W5TSU/LinHT-hw/audio.kicad_sch

## KiCad design audio.kicad_sch (2026-09-17)

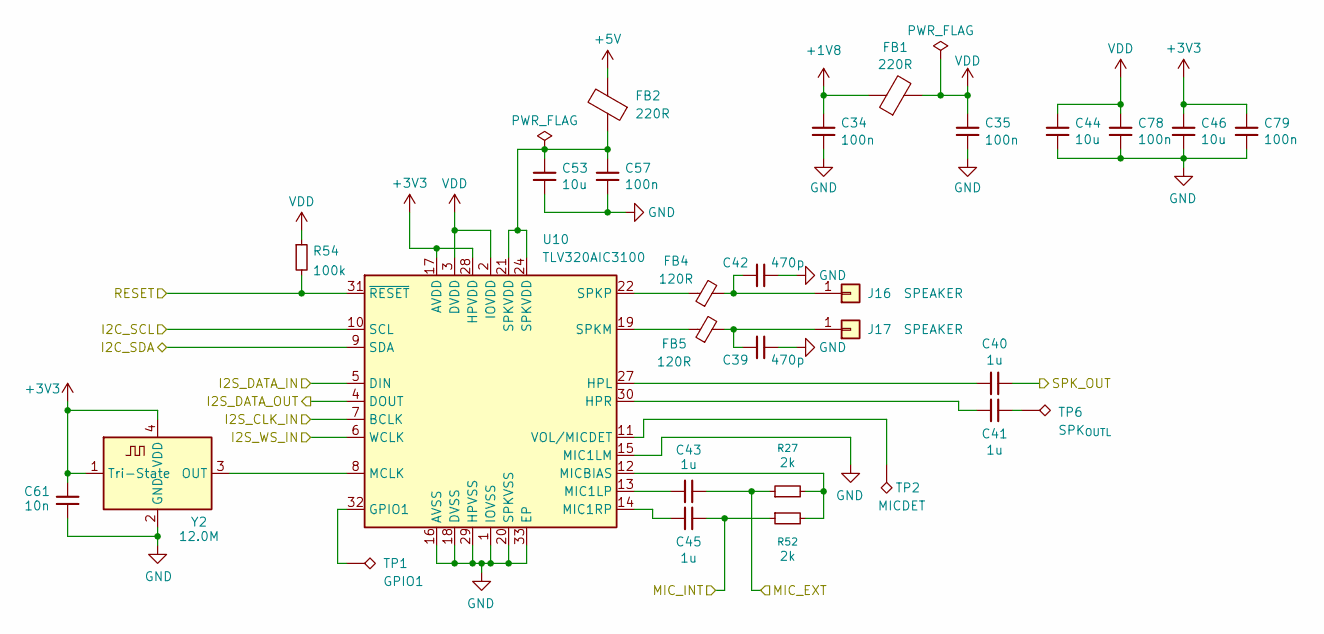
[picture p1: schematic audio.kicad_sch]

Parts:
C34, C35, C57, C78, C79: 100n; C_0402_1005Metric; MPN CL05B104KO5NNNC; LCSC C1525
C39, C42: 470p; C_0402_1005Metric; MPN CC0402JRNPO9BN471; LCSC C106259
C40, C41, C43, C45: 1u; C_0402_1005Metric; MPN CL05A105KA5NQNC; LCSC C52923
C44, C46, C53: 10u; C_0402_1005Metric; MPN CL05A106MQ5NUNC; LCSC C15525
C61: 10n; C_0402_1005Metric; MPN CL05B103KO5NNNC; LCSC C318577
FB1, FB2: 220R; L_0805_2012Metric; MPN BLM21PG221SN1D; LCSC C85840
FB4, FB5: 120R; L_0805_2012Metric; MPN BLM21PG121SN1D; LCSC C79382
J16, J17: SPEAKER; TestPoint_Pad_D4.0mm
R27, R52: 2k; R_0402_1005Metric; MPN 0402WGF2001TCE; LCSC C4109
R54: 100k; R_0402_1005Metric; MPN 0402WGF1003TCE; LCSC C25741
TP1: GPIO1; TestPoint_Pad_D1.0mm
TP2: MICDET; TestPoint_Pad_D1.0mm
TP6: SPK_{OUTL}; TestPoint_Pad_D1.0mm
U10: TLV320AIC3100; VQFN-32-1EP_5x5mm_P0.5mm_EP3.5x3.5mm; MPN TLV320AIC3100IRHBR; LCSC C478458
Y2: 12.0M; Oscillator_SMD_ECS_2520MV-xxx-xx-4Pin_2.5x2.0mm; MPN ECS-2520MV-120-BN-TR; LCSC C17241106

Connections:
+1V8: C34.1, FB1.1
+3V3: C46.1, C61.1, C79.1, U10.17 (AVDD), U10.28 (HPVDD), Y2.1 (Tri-State), Y2.4 (VDD)
+5V: FB2.2
GND: C34.2, C35.2, C39.2, C42.2, C44.2, C46.2, C53.2, C57.2, C61.2, C78.2, C79.2, U10.1 (IOVSS), U10.15 (MIC1LM), U10.16 (AVSS), U10.18 (DVSS), U10.20 (SPKVSS), U10.25 (SPKVSS), U10.29 (HPVSS), U10.33 (EP), Y2.2 (GND)
I2C_SCL: U10.10 (SCL)
I2C_SDA: U10.9 (SDA)
I2S_CLK_IN: U10.7 (BCLK)
I2S_DATA_IN: U10.5 (DIN)
I2S_DATA_OUT: U10.4 (DOUT)
I2S_WS_IN: U10.6 (WCLK)
MIC_EXT: C43.2, R27.1
MIC_INT: C45.2, R52.1
unnamed: C39.1, FB5.2, J17.1
unnamed: C40.2, U10.27 (HPL)
unnamed: C41.1, TP6.1
unnamed: C41.2, U10.30 (HPR)
unnamed: C42.1, FB4.2, J16.1
unnamed: C43.1, U10.13 (MIC1LP)
unnamed: C45.1, U10.14 (MIC1RP)
unnamed: C53.1, C57.1, FB2.1, U10.21 (SPKVDD), U10.24 (SPKVDD)
unnamed: FB4.1, U10.22 (SPKP), U10.26 (SPKP)
unnamed: FB5.1, U10.19 (SPKM), U10.23 (SPKM)
unnamed: R27.2, R52.2, U10.12 (MICBIAS)
unnamed: TP1.1, U10.32 (GPIO1)
unnamed: TP2.1, U10.11 (VOL/MICDET)
unnamed: U10.8 (MCLK), Y2.3 (OUT)
RESET: R54.2, U10.31 (~RESET)
SPK_OUT: C40.1
VDD: C35.1, C44.1, C78.1, FB1.2, R54.1, U10.2 (IOVDD), U10.3 (DVDD)
