W5TSU/LinHT-hw/connectors.kicad_sch

## KiCad design connectors.kicad_sch (2026-09-17)

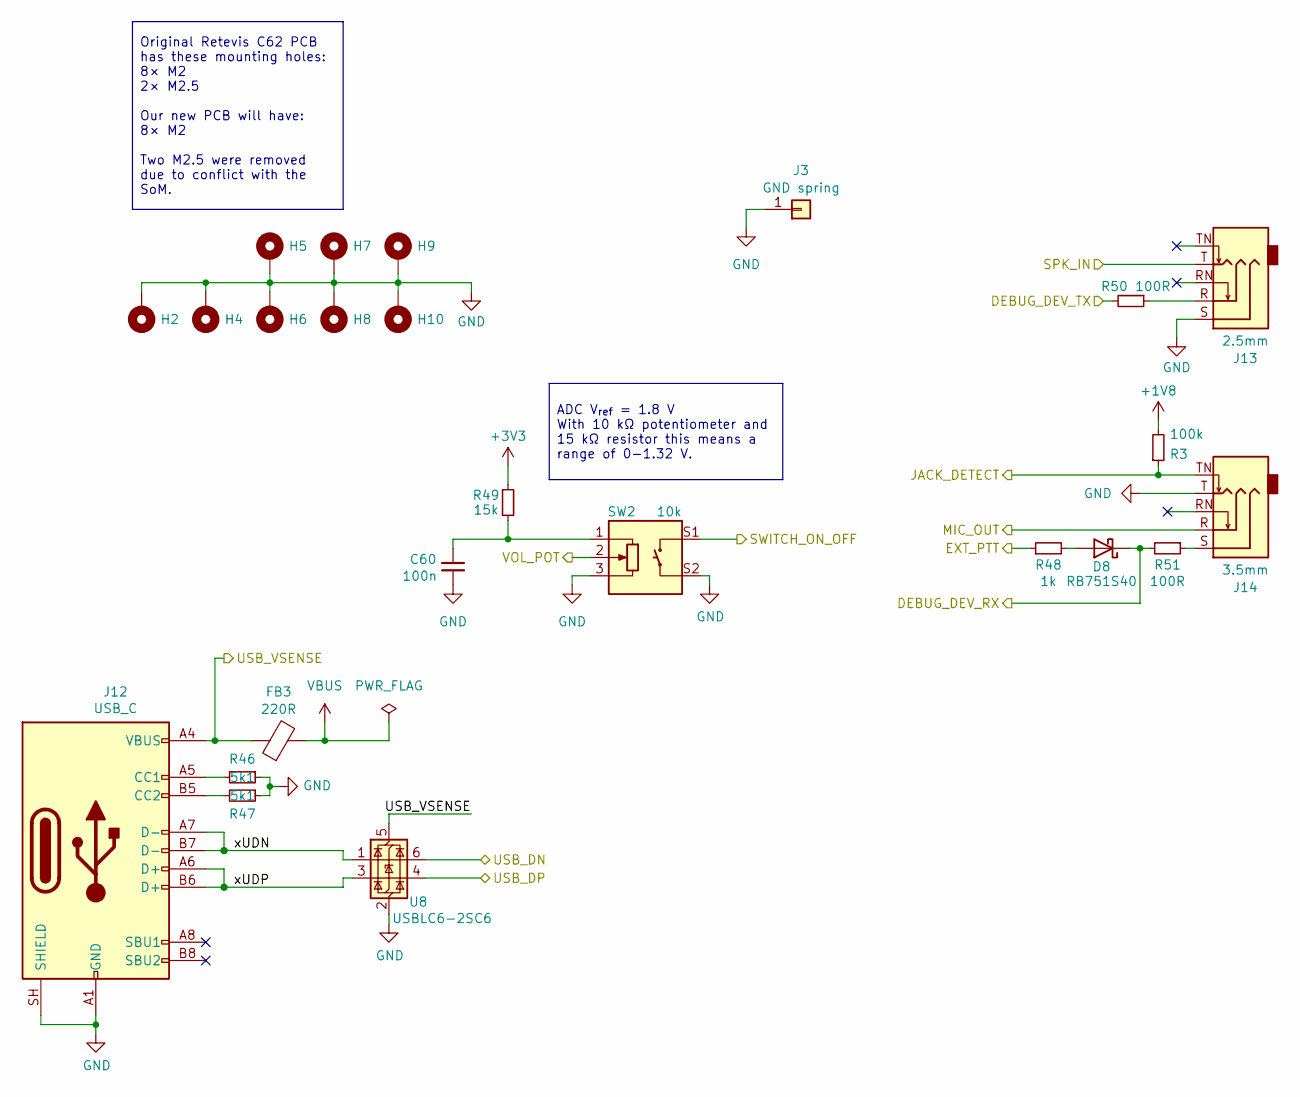
[picture p2: schematic connectors.kicad_sch]

Parts:
C60: 100n; C_0402_1005Metric; MPN CL05B104KO5NNNC; LCSC C1525
D8: RB751S40; D_SOD-523; MPN RB751S40T1G; LCSC C5178963
FB3: 220R; L_0805_2012Metric; MPN BLM21PG221SN1D; LCSC C85840
H2, H4, H5, H6, H7, H8, H9, H10: MountingHole_Pad; MountingHole_2.2mm_M2_DIN965_Pad
J3: GND spring; TestPoint_Pad_D4.0mm
J12: USB_C; USB_C_Receptacle_HRO_TYPE-C-31-M-12; MPN TYPE-C-31-M-12; LCSC C165948
J13: 2.5mm; Jack_2.5mm_PJ-204_nodrill_Horizontal
J14: 3.5mm; Jack_3.5mm_CUI_SJ1-3525N_Modified
R3: 100k; R_0402_1005Metric; MPN 0402WGF1003TCE; LCSC C25741
R46, R47: 5k1; R_0402_1005Metric; MPN 0402WGF5101TCE; LCSC C25905
R48: 1k; R_0402_1005Metric; MPN 0402WGF1001TCE; LCSC C11702
R49: 15k; R_0402_1005Metric; MPN 0402WGF1502TCE; LCSC C25756
R50, R51: 100R; R_0402_1005Metric; MPN 0402WGF1000TCE; LCSC C25076
SW2: 10k; Connector_08x09mm_pot_switch
U8: USBLC6-2SC6; SOT-23-6; MPN USBLC6-2-SC6; LCSC C7519

Connections:
+1V8: R3.2
+3V3: R49.1
DEBUG_DEV_RX: D8.1 (K), R51.2
DEBUG_DEV_TX: R50.2
EXT_PTT: R48.1
GND: C60.2, H2.1, H4.1, H5.1, H6.1, H7.1, H8.1, H9.1, H10.1, J3.1, J12.A1 (GND), J12.A12 (GND), J12.B1 (GND), J12.B12 (GND), J12.SH (SHIELD), J13.S, J14.T, R46.1, R47.1, SW2.3, SW2.S2, U8.2 (GND)
JACK_DETECT: J14.TN, R3.1
MIC_OUT: J14.R
unnamed: C60.1, R49.2, SW2.1
unnamed: D8.2 (A), R48.2
unnamed: J12.A5 (CC1), R46.2
unnamed: J12.B5 (CC2), R47.2
unnamed: J13.R, R50.1
unnamed: J14.S, R51.1
SPK_IN: J13.T
SWITCH_ON_OFF: SW2.S1
USB_DN: U8.6 (I/O1)
USB_DP: U8.4 (I/O2)
USB_VSENSE: FB3.1, J12.A4 (VBUS), J12.A9 (VBUS), J12.B4 (VBUS), J12.B9 (VBUS), U8.5 (VBUS)
VBUS: FB3.2
VOL_POT: SW2.2
xUDN: J12.A7 (D-), J12.B7 (D-), U8.1 (I/O1)
xUDP: J12.A6 (D+), J12.B6 (D+), U8.3 (I/O2)

Notes on the sheet:
ADC V_{ref} = 1.8 V With 10 kΩ potentiometer and 15 kΩ resistor this means a range of 0-1.32 V.
Original Retevis C62 PCB has these mounting holes: 8× M2 2× M2.5 Our new PCB will have: 8× M2 Two M2.5 were removed due to conflict with the SoM.
