W5TSU/LinHT-hw/display.kicad_sch

## KiCad design display.kicad_sch (2026-09-17)

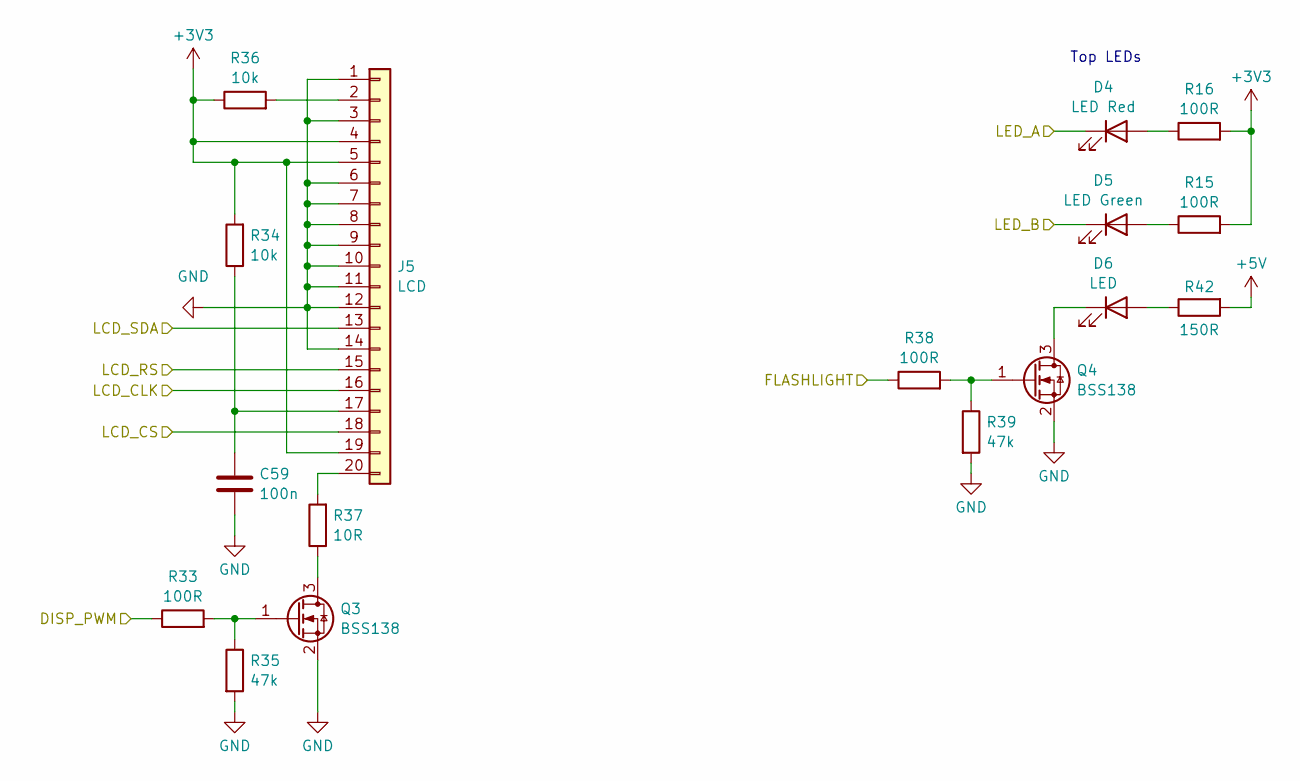
[picture p3: schematic display.kicad_sch]

Parts:
C59: 100n; C_0402_1005Metric; MPN CL05B104KO5NNNC; LCSC C1525
D4: LED Red; LED_0402_1005Metric; MPN SM0402RC
D5: LED Green; LED_0402_1005Metric; MPN SM0402GC
D6: LED; LED_Rectangular_W3.0mm_H2.0mm
J5: LCD; Connector_FFC_01x20_P0.75mm
Q3, Q4: BSS138; SOT-23; MPN BSS138-7-F; LCSC C40912
R15, R16, R33, R38: 100R; R_0402_1005Metric; MPN 0402WGF1000TCE; LCSC C25076
R34, R36: 10k; R_0402_1005Metric; MPN 0402WGF1002TCE; LCSC C25744
R35, R39: 47k; R_0402_1005Metric; MPN 0402WGF4702TCE; LCSC C25792
R37: 10R; R_0402_1005Metric; MPN 0402WGF100JTCE; LCSC C25077
R42: 150R; R_0402_1005Metric; MPN 0402WGF1500TCE; LCSC C25082

Connections:
+3V3: J5.4, J5.5, J5.19, R15.2, R16.2, R34.2, R36.1
+5V: R42.2
DISP_PWM: R33.1
FLASHLIGHT: R38.1
GND: C59.2, J5.1, J5.3, J5.6, J5.7, J5.8, J5.9, J5.10, J5.11, J5.12, J5.14, Q3.2 (S), Q4.2 (S), R35.2, R39.2
LCD_CLK: J5.16
LCD_CS: J5.18
LCD_RS: J5.15
LCD_SDA: J5.13
LED_A: D4.1 (K)
LED_B: D5.1 (K)
unnamed: C59.1, J5.17, R34.1
unnamed: D4.2 (A), R16.1
unnamed: D5.2 (A), R15.1
unnamed: D6.1 (K), Q4.3 (D)
unnamed: D6.2 (A), R42.1
unnamed: J5.2, R36.2
unnamed: J5.20, R37.2
unnamed: Q3.1 (G), R33.2, R35.1
unnamed: Q3.3 (D), R37.1
unnamed: Q4.1 (G), R38.2, R39.1

Notes on the sheet:
Top LEDs
