W5TSU/LinHT-hw/gnss.kicad_sch

## KiCad design gnss.kicad_sch (2026-09-17)

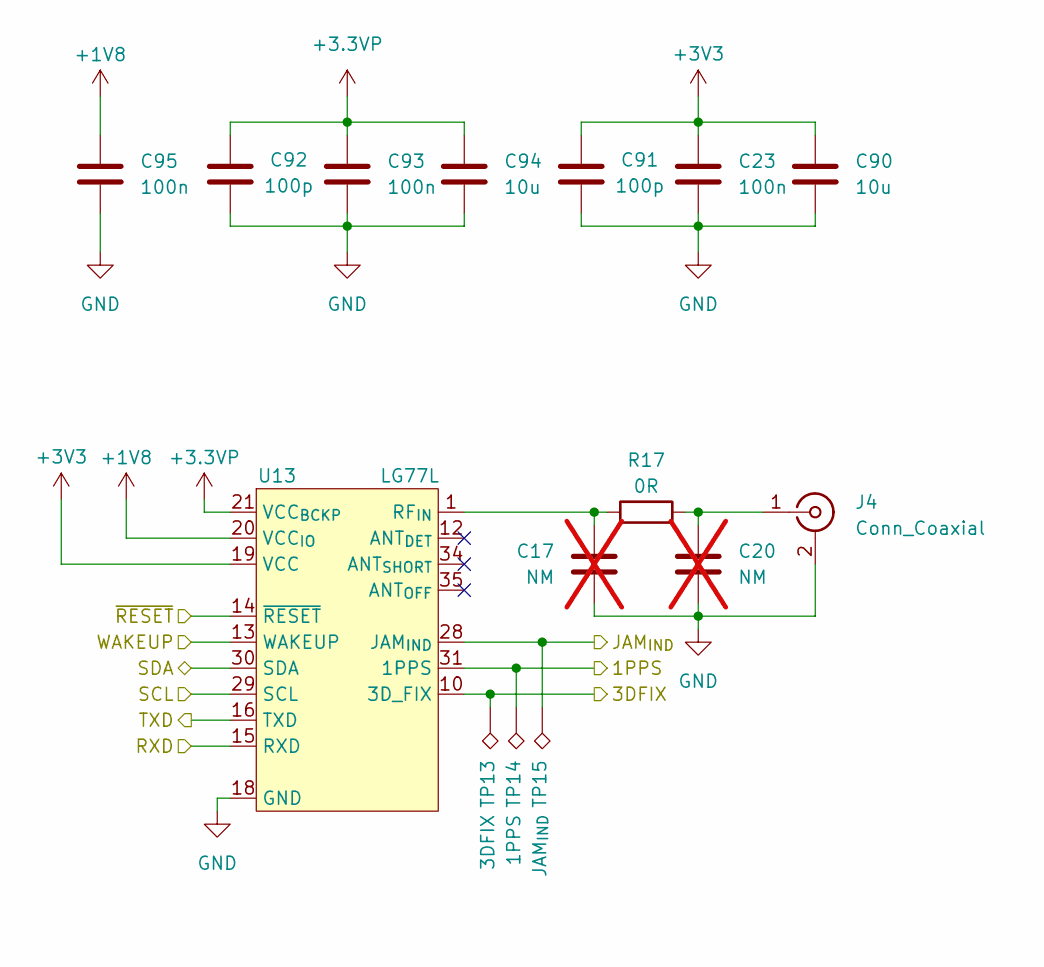
[picture p4: schematic gnss.kicad_sch]

Parts:
C17, C20: NM; C_0402_1005Metric; not fitted
C23, C93, C95: 100n; C_0402_1005Metric; MPN CL05B104KO5NNNC; LCSC C1525
C90, C94: 10u; C_0805_2012Metric; MPN CL21A106KBYQNNE; LCSC C2932476
C91, C92: 100p; C_0402_1005Metric; MPN GRM1555C1H101JA01D; LCSC C77177
J4: Conn_Coaxial; Connector_ufl_1909763-1; MPN 1909763-1; LCSC C392444
R17: 0R; R_0402_1005Metric; MPN 0402WGF0000TCE; LCSC C17168
TP13: 3DFIX; TestPoint_Pad_D1.0mm
TP14: 1PPS; TestPoint_Pad_D1.0mm
TP15: JAM_{IND}; TestPoint_Pad_D1.0mm
U13: LG77L; MPN LG77LICMD

Connections:
1PPS: TP14.1, U13.31 (1PPS)
3DFIX: TP13.1, U13.10 (3D_FIX)
+1V8: C95.1, U13.20 (VCC_{IO})
+3.3VP: C92.2, C93.1, C94.1, U13.21 (VCC_{BCKP})
+3V3: C23.1, C90.1, C91.2, U13.19 (VCC)
GND: C17.2, C20.2, C23.2, C90.2, C91.1, C92.1, C93.2, C94.2, C95.2, J4.2 (Ext), U13.2 (GND), U13.18 (GND), U13.37 (GND), U13.38 (GND), U13.39 (GND), U13.40 (GND), U13.41 (GND), U13.42 (GND), U13.43 (GND)
JAM_{IND}: TP15.1, U13.28 (JAM_{IND})
unnamed: C17.1, R17.1, U13.1 (RF_{IN})
unnamed: C20.1, J4.1 (In), R17.2
unnamed: U13.3 (RES), U13.4 (RES), U13.5 (RES), U13.6 (RES), U13.7 (RES), U13.8 (RES), U13.9 (RES), U13.11 (RES), U13.17 (RES), U13.22 (RES), U13.23 (RES), U13.24 (RES), U13.25 (RES), U13.26 (RES), U13.27 (RES), U13.32 (RES), U13.33 (RES), U13.36 (RES)
RXD: U13.15 (RXD)
SCL: U13.29 (SCL)
SDA: U13.30 (SDA)
TXD: U13.16 (TXD)
WAKEUP: U13.13 (WAKEUP)
~RESET: U13.14 (~RESET)
