W5TSU/LinHT-hw/keyboard.kicad_sch

## KiCad design keyboard.kicad_sch (2026-09-17)

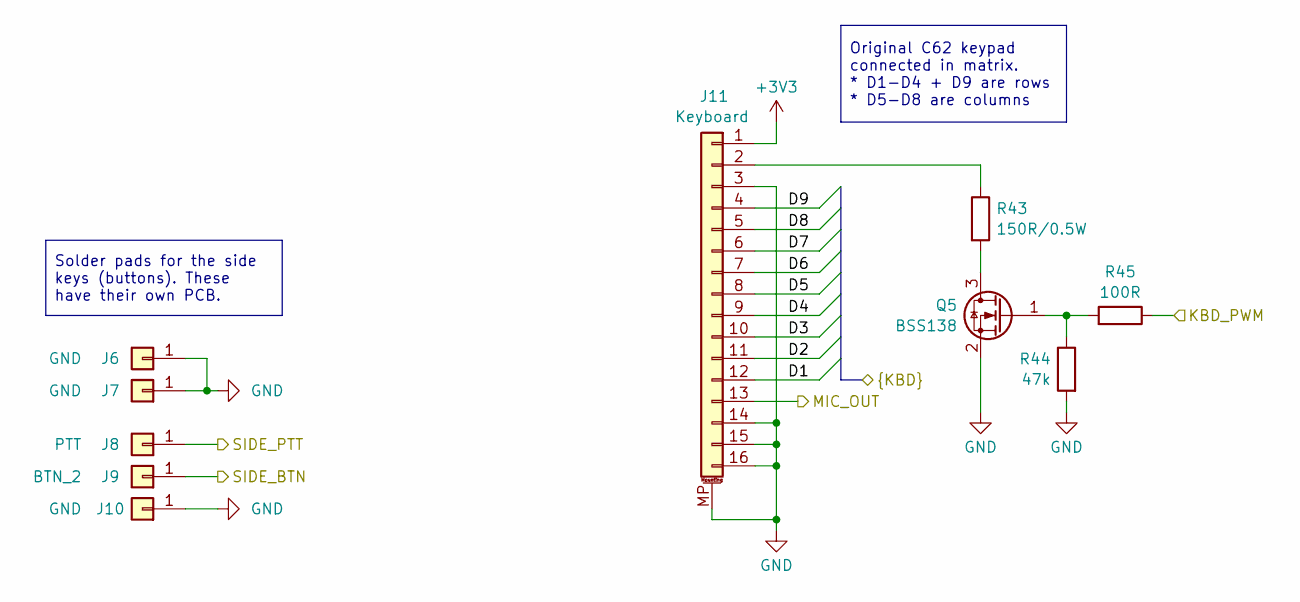
[picture p5: schematic keyboard.kicad_sch]

Parts:
J6, J7, J10: GND; Solder_Pad-1.7x2.2mm
J8: PTT; Solder_Pad-1.7x2.2mm
J9: BTN_2; Solder_Pad-1.7x2.2mm
J11: Keyboard; FPC-SMD_P0.50-16P_FGS-XJ-H2.0; MPN FH12-16S-0.5SH(55)
Q5: BSS138; SOT-23; MPN BSS138-7-F; LCSC C40912
R43: 150R/0.5W; R_0402_1005Metric; MPN ERJPA2F1500X; LCSC C542965
R44: 47k; R_0402_1005Metric; MPN 0402WGF4702TCE; LCSC C25792
R45: 100R; R_0402_1005Metric; MPN 0402WGF1000TCE; LCSC C25076

Connections:
+3V3: J11.1
D1: J11.12
D2: J11.11
D3: J11.10
D4: J11.9
D5: J11.8
D6: J11.7
D7: J11.6
D8: J11.5
D9: J11.4
GND: J6.1, J7.1, J10.1, J11.3, J11.14, J11.15, J11.16, J11.MP (MountPin), Q5.2 (S), R44.2
KBD_PWM: R45.1
MIC_OUT: J11.13
unnamed: J11.2, R43.1
unnamed: Q5.1 (G), R44.1, R45.2
unnamed: Q5.3 (D), R43.2
SIDE_BTN: J9.1
SIDE_PTT: J8.1

Notes on the sheet:
Original C62 keypad connected in matrix. * D1-D4 + D9 are rows * D5-D8 are columns
Solder pads for the side keys (buttons). These have their own PCB.
