W5TSU/LinHT-hw/linht-hw.kicad_sch

## KiCad design linht-hw.kicad_sch (2026-09-17)

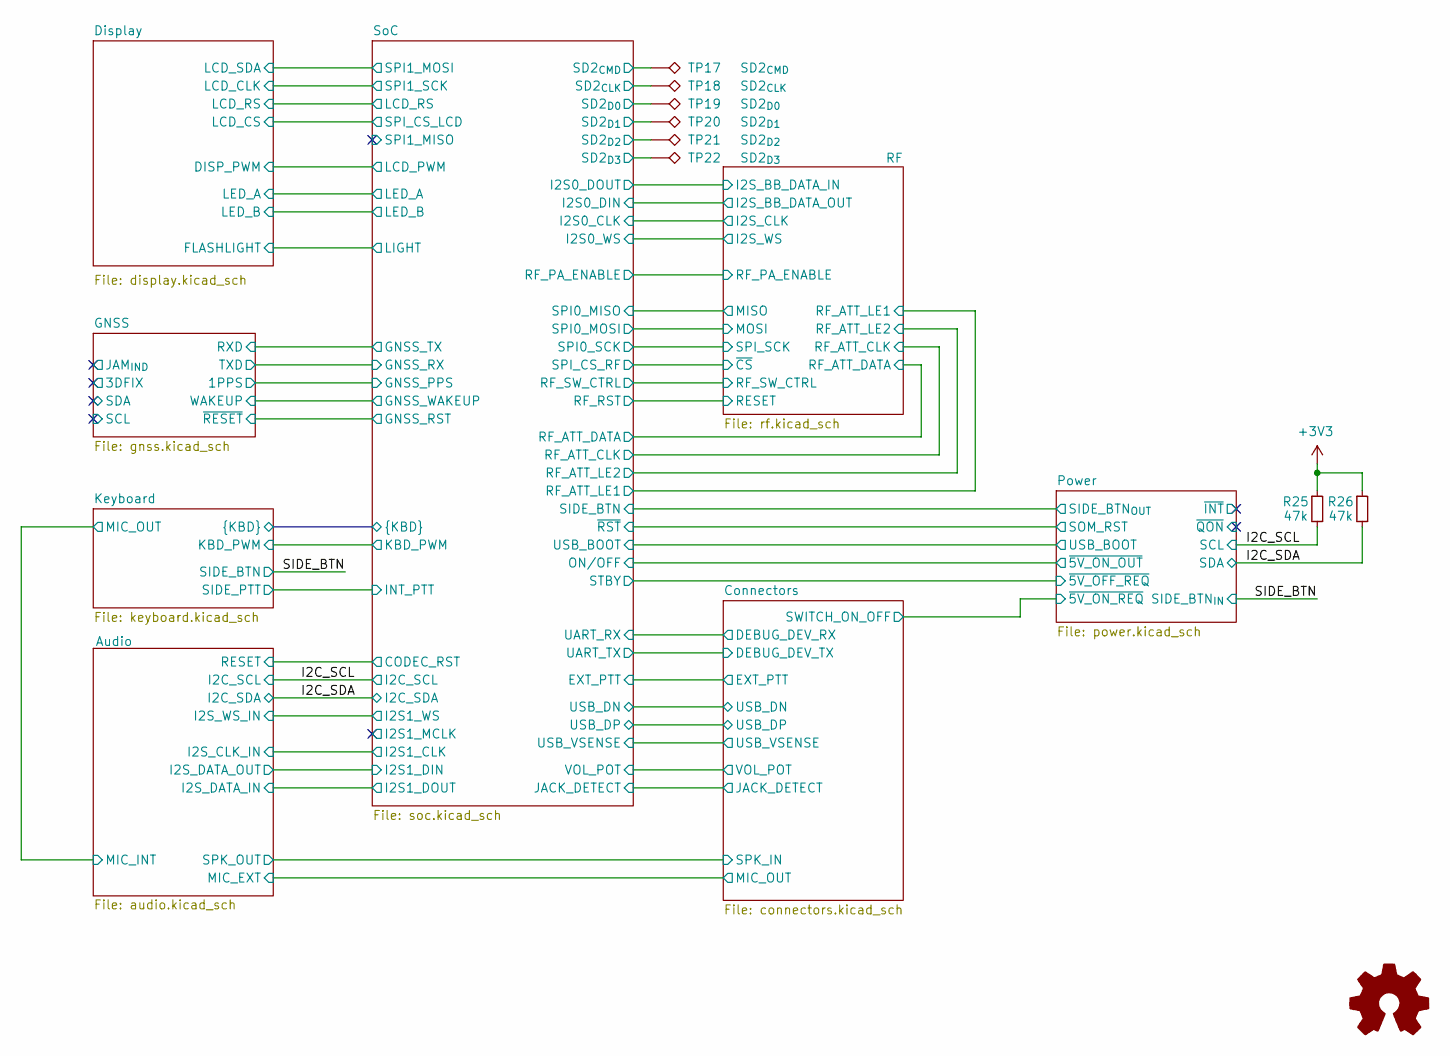
[picture p6: schematic linht-hw.kicad_sch]

Parts:
R25, R26: 47k; R_0402_1005Metric; MPN 0402WGF4702TCE; LCSC C25792
SYM1: Logo_Open_Hardware_Small; OSHW-Logo2_14.6x12mm_SilkScreen
TP17: SD2_{CMD}; TestPoint_Pad_D1.0mm
TP18: SD2_{CLK}; TestPoint_Pad_D1.0mm
TP19: SD2_{D0}; TestPoint_Pad_D1.0mm
TP20: SD2_{D1}; TestPoint_Pad_D1.0mm
TP21: SD2_{D2}; TestPoint_Pad_D1.0mm
TP22: SD2_{D3}; TestPoint_Pad_D1.0mm

Connections:
+3V3: R25.1, R26.1
I2C_SCL: R25.2
I2C_SDA: R26.2
SD2_{CLK}: TP18.1
SD2_{CMD}: TP17.1
SD2_{D0}: TP19.1
SD2_{D1}: TP20.1
SD2_{D2}: TP21.1
SD2_{D3}: TP22.1
