W5TSU/LinHT-hw/mux.kicad_sch

## KiCad design mux.kicad_sch (2026-09-17)

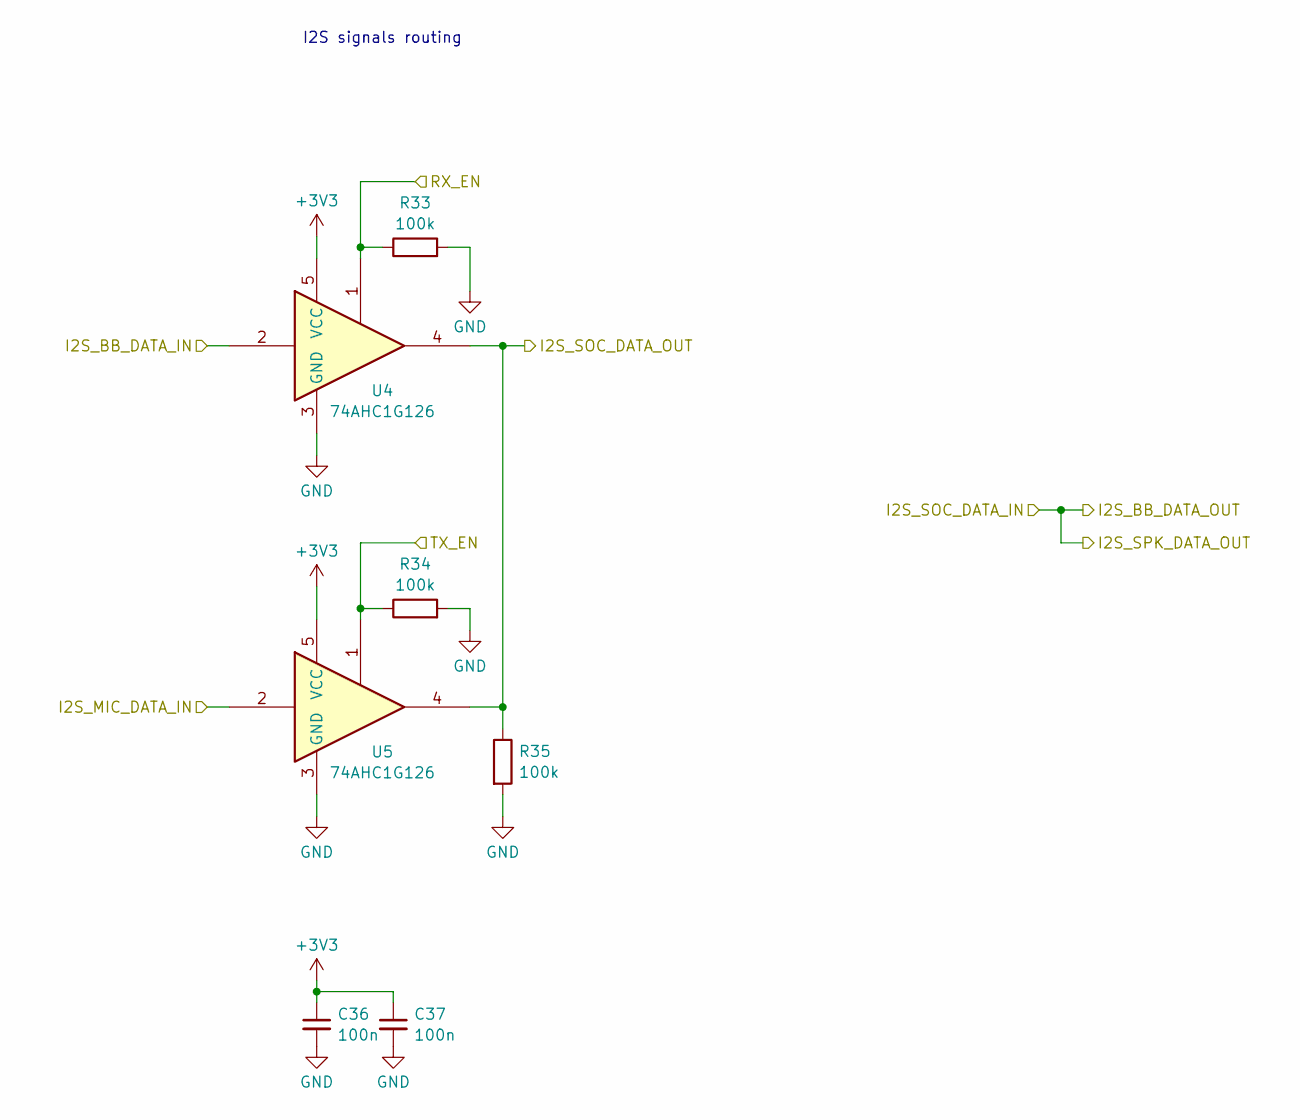
[picture p7: schematic mux.kicad_sch]

Parts:
C36, C37: 100n; C_0402_1005Metric
R33, R34, R35: 100k; R_0402_1005Metric
U4, U5: 74AHC1G126

Connections:
+3V3: C36.1, C37.1, U4.5 (VCC), U5.5 (VCC)
GND: C36.2, C37.2, R33.2, R34.2, R35.2, U4.3 (GND), U5.3 (GND)
I2S_BB_DATA_IN: U4.2
I2S_MIC_DATA_IN: U5.2
I2S_SOC_DATA_OUT: R35.1, U4.4, U5.4
RX_EN: R33.1, U4.1
TX_EN: R34.1, U5.1

Notes on the sheet:
I2S signals routing
