W5TSU/LinHT-hw/power.kicad_sch

## KiCad design power.kicad_sch (2026-09-17)

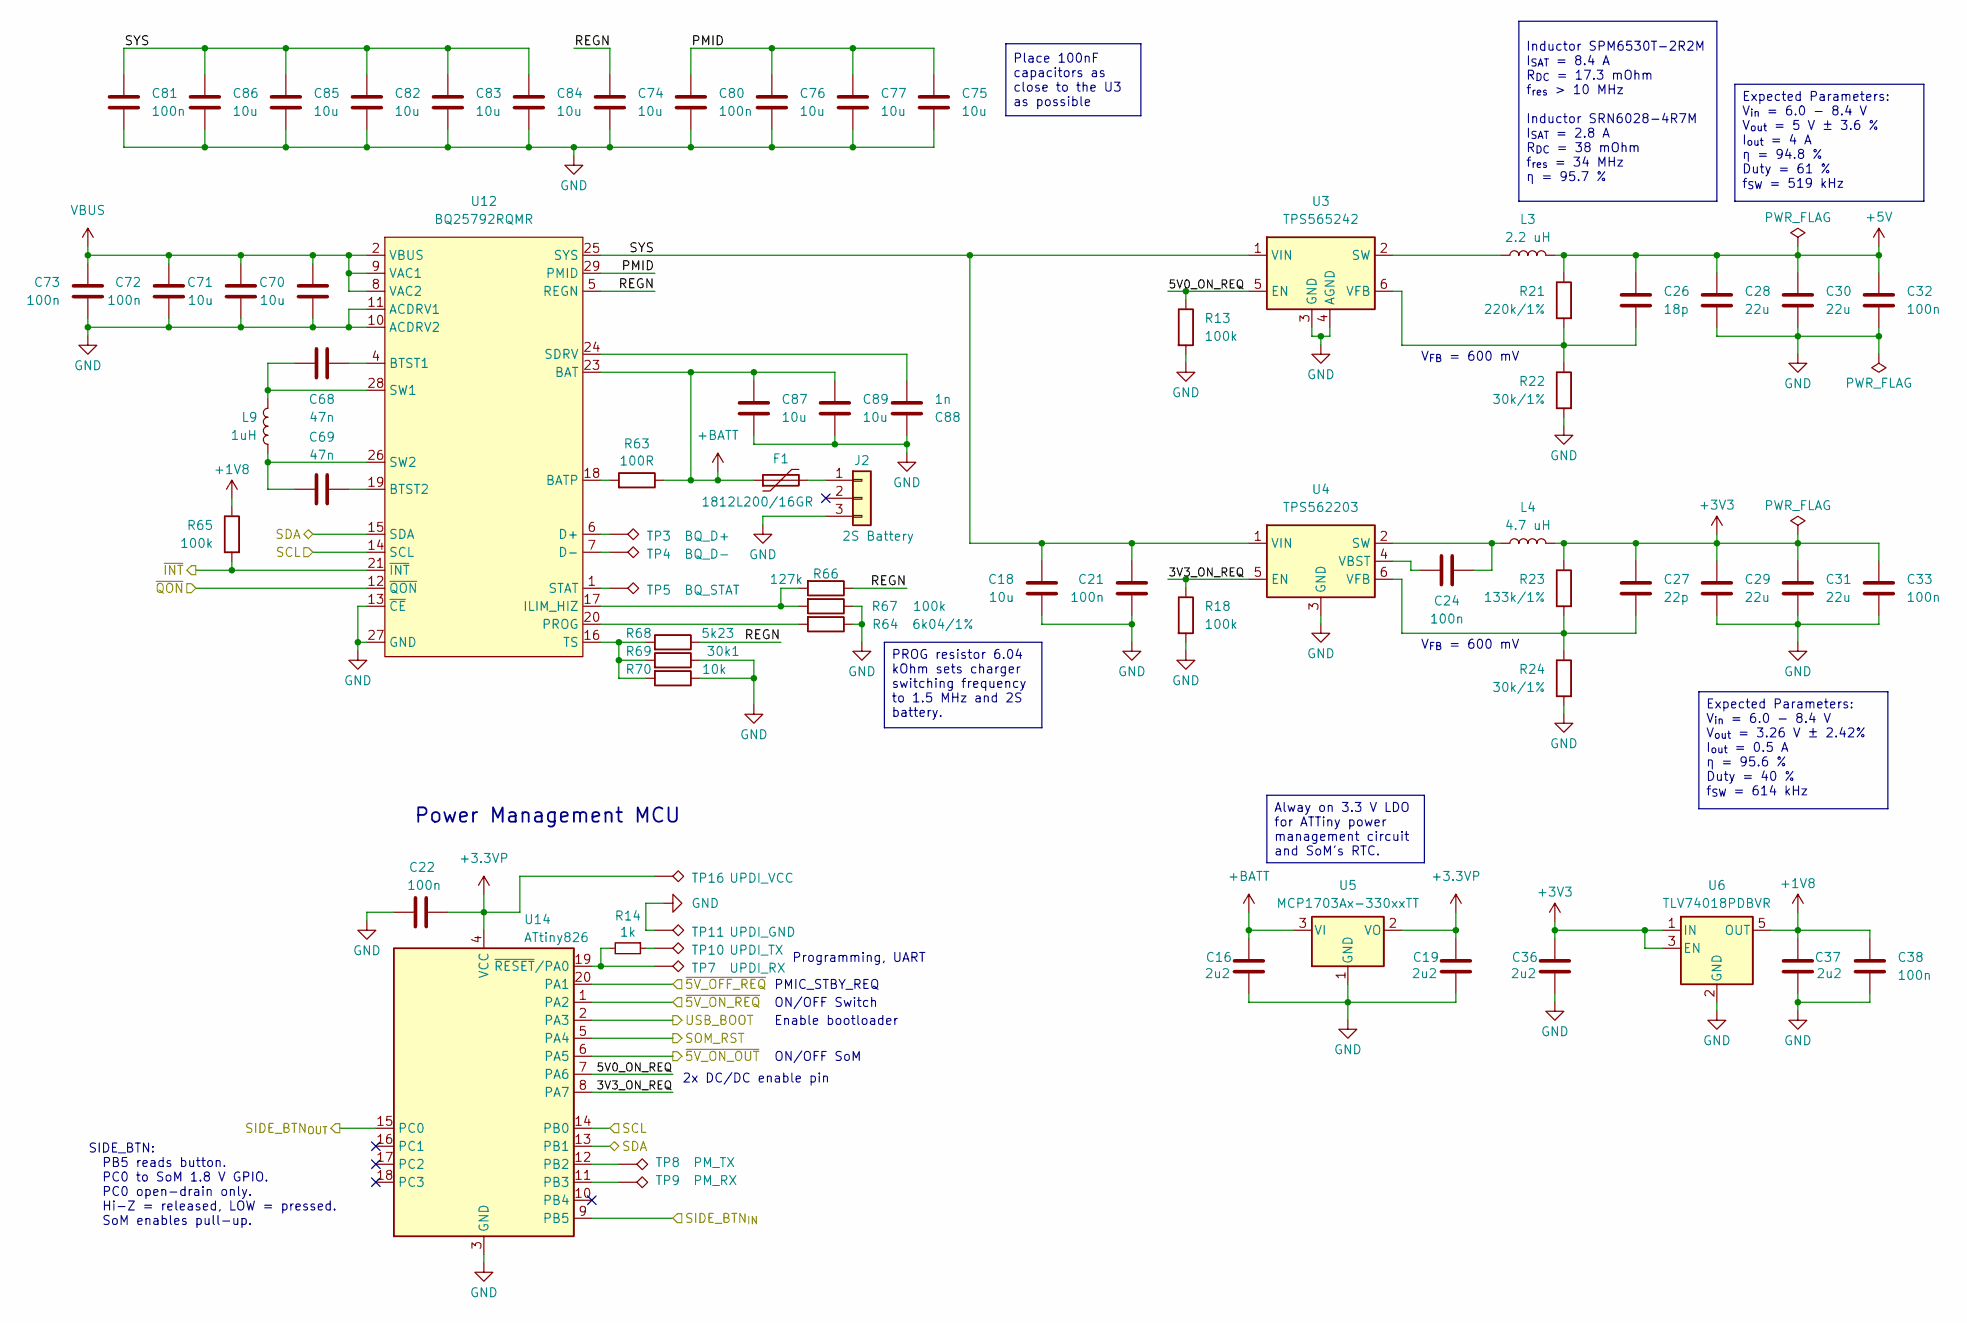
[picture p8: schematic power.kicad_sch]

Parts:
C16, C19, C36, C37: 2u2; C_0402_1005Metric; MPN CL05A225KO5NQNC; LCSC C170151
C18, C70, C71, C74, C75, C76, C77, C82, C83, C84, C85, C86, C87, C89: 10u; C_0805_2012Metric; MPN CL21A106KBYQNNE; LCSC C2932476
C21, C22, C24, C32, C33, C38, C72, C73, C80, C81: 100n; C_0402_1005Metric; MPN CL05B104KO5NNNC; LCSC C1525
C26: 18p; C_0402_1005Metric; MPN CC402JRNPO9BN180; LCSC C106202
C27: 22p; C_0402_1005Metric; MPN CC0402JRNPO9BN220; LCSC C106203
C28, C29, C30, C31: 22u; C_1206_3216Metric; MPN CL31B226KPHNNNE; LCSC C87996
C68, C69: 47n; C_0402_1005Metric; MPN CL05B473KO5NNNC; LCSC C307434
C88: 1n; C_0402_1005Metric; MPN CC0402JRNPO9BN102; LCSC C113780
F1: 1812L200/16GR; Fuse_1812L200; MPN 1812L200/16GR; LCSC C18198340
J2: 2S Battery; Connector_01x03_BT-003E
L3: 2.2 uH; L_TDK_SPM6530; MPN SPM6530T-2R2M; LCSC C76855
L4: 4.7 uH; L_Bourns-SRN6028C; MPN SRN6028C-4R7M; LCSC C19947654
L9: 1uH; SLO0520H1R0MTT; MPN SLO0520H1R0MTT; LCSC C325980
R13, R18, R65, R67: 100k; R_0402_1005Metric; MPN 0402WGF1003TCE; LCSC C25741
R14: 1k; R_0402_1005Metric; MPN 0402WGF1001TCE; LCSC C11702
R21: 220k/1%; R_0402_1005Metric; MPN 0402WGF2203TCE; LCSC C25767
R22, R24: 30k/1%; R_0402_1005Metric; MPN 0402WGF3002TCE; LCSC C25776
R23: 133k/1%; R_0402_1005Metric; MPN RC0402FR-07133KL
R63: 100R; R_0402_1005Metric; MPN 0402WGF1000TCE; LCSC C25076
R64: 6k04/1%; R_0402_1005Metric; MPN 0402WGF6041TCE; LCSC C25913
R66: 127k; R_0402_1005Metric; MPN 0402WGF1273TCE; LCSC C25751
R68: 5k23; R_0402_1005Metric; MPN 0402WGF5231TCE; LCSC C25907
R69: 30k1; R_0402_1005Metric; MPN 0402WGF3012TCE; LCSC C29402
R70: 10k; R_0402_1005Metric; MPN 0402WGF1002TCE; LCSC C25744
TP3: BQ_D+; TestPoint_Pad_D1.0mm
TP4: BQ_D-; TestPoint_Pad_D1.0mm
TP5: BQ_STAT; TestPoint_Pad_D1.0mm
TP7: UPDI_RX; TestPoint_Pad_D1.0mm
TP8: PM_TX; TestPoint_Pad_D1.0mm
TP9: PM_RX; TestPoint_Pad_D1.0mm
TP10: UPDI_TX; TestPoint_Pad_D1.0mm
TP11: UPDI_GND; TestPoint_Pad_D1.0mm
TP16: UPDI_VCC; TestPoint_Pad_D1.0mm
U3: TPS565242; SOT-563; MPN TPS565242DRLR; LCSC C5219270
U4: TPS562203; SOT-563; MPN TPS562203DRLR; LCSC C22445511
U5: MCP1703Ax-330xxTT; SOT-23; MPN MCP1703AT-3302E/CB; LCSC C144183
U6: TLV74018PDBVR; SOT-23-5; MPN TLV74018PDBVR; LCSC C3746861
U12: BQ25792RQMR; QFN-29_L4.0-W4.0-P0.40-TL-BQ25792RQMR; MPN BQ25792RQMR; LCSC Part C2862876
U14: ATtiny826; VQFN-20-1EP_3x3mm_P0.4mm_EP1.7x1.7mm; MPN ATTINY826-MU; LCSC C3216887

Connections:
3V3_ON_REQ: R18.1, U4.5 (EN), U14.8 (PA7)
5V0_ON_REQ: R13.1, U3.5 (EN), U14.7 (PA6)
+1V8: C37.1, C38.1, R65.1, U6.5 (OUT)
+3.3VP: C19.1, C22.1, TP16.1, U5.2 (VO), U14.4 (VCC)
+3V3: C27.1, C29.1, C31.1, C33.1, C36.1, L4.2, R23.1, U6.1 (IN), U6.3 (EN)
+5V: C26.1, C28.1, C30.1, C32.1, L3.2, R21.1
+BATT: C16.1, C87.1, C89.1, F1.1, R63.1, U5.3 (VI), U12.22 (BAT), U12.23 (BAT)
GND: C16.2, C18.2, C19.2, C21.2, C22.2, C28.2, C29.2, C30.2, C31.2, C32.2, C33.2, C36.2, C37.2, C38.2, C70.2, C71.2, C72.2, C73.2, C74.2, C75.2, C76.2, C77.2, C80.2, C81.2, C82.2, C83.2, C84.2, C85.2, C86.2, C87.2, C88.2, C89.2, J2.3, R13.2, R18.2, R22.2, R24.2, R64.1, R67.1, R69.1, R70.1, TP11.1, U3.3 (GND), U3.4 (AGND), U4.3 (GND), U5.1 (GND), U6.2 (GND), U12.10 (ACDRV2), U12.11 (ACDRV1), U12.13 (~CE), U12.27 (GND), U14.3 (GND), U14.21 (GND)
unnamed: C24.1, U4.4 (VBST)
unnamed: C24.2, L4.1, U4.2 (SW)
unnamed: C26.2, R21.2, R22.1, U3.6 (VFB)
unnamed: C27.2, R23.2, R24.1, U4.6 (VFB)
unnamed: C68.1, L9.2, U12.28 (SW1)
unnamed: C68.2, U12.4 (BTST1)
unnamed: C69.1, L9.1, U12.26 (SW2)
unnamed: C69.2, U12.19 (BTST2)
unnamed: C88.1, U12.24 (SDRV)
unnamed: F1.2, J2.1
unnamed: L3.1, U3.2 (SW)
unnamed: R14.1, TP10.1
unnamed: R14.2, TP7.1, U14.19 (~RESET/PA0)
unnamed: R63.2, U12.18 (BATP)
unnamed: R64.2, U12.20 (PROG)
unnamed: R66.2, R67.2, U12.17 (ILIM_HIZ)
unnamed: R68.2, R69.2, R70.2, U12.16 (TS)
unnamed: TP3.1, U12.6 (D+)
unnamed: TP4.1, U12.7 (D-)
unnamed: TP5.1, U12.1 (STAT)
unnamed: TP8.1, U14.12 (PB2)
unnamed: TP9.1, U14.11 (PB3)
PMID: C75.1, C76.1, C77.1, C80.1, U12.29 (PMID)
REGN: C74.1, R66.1, R68.1, U12.5 (REGN)
SCL: U12.14 (SCL), U14.14 (PB0)
SDA: U12.15 (SDA), U14.13 (PB1)
SIDE_BTN_{IN}: U14.9 (PB5)
SIDE_BTN_{OUT}: U14.15 (PC0)
SOM_RST: U14.5 (PA4)
SYS: C18.1, C21.1, C81.1, C82.1, C83.1, C84.1, C85.1, C86.1, U3.1 (VIN), U4.1 (VIN), U12.25 (SYS)
USB_BOOT: U14.2 (PA3)
VBUS: C70.1, C71.1, C72.1, C73.1, U12.2 (VBUS), U12.3 (VBUS), U12.8 (VAC2), U12.9 (VAC1)
~5V_OFF_REQ: U14.20 (PA1)
~5V_ON_OUT: U14.6 (PA5)
~5V_ON_REQ: U14.1 (PA2)
~INT: R65.2, U12.21 (~INT)
~QON: U12.12 (~QON)

Notes on the sheet:
V_{FB} = 600 mV
Enable bootloader
Power Management MCU
2x DC/DC enable pin
ON/OFF Switch
ON/OFF SoM
Programming, UART
SIDE_BTN: PB5 reads button. PC0 to SoM 1.8 V GPIO. PC0 open-drain only. Hi-Z = released, LOW = pressed. SoM enables pull-up.
PMIC_STBY_REQ
Place 100nF capacitors as close to the U3 as possible
Inductor SPM6530T-2R2M I_{SAT} = 8.4 A R_{DC} = 17.3 mOhm f_{res} > 10 MHz Inductor SRN6028-4R7M I_{SAT} = 2.8 A R_{DC} = 38 mOhm f_{res} = 34 MHz η = 95.7 %
PROG resistor 6.04 kOhm sets charger switching frequency to 1.5 MHz and 2S battery.
Alway on 3.3 V LDO for ATTiny power management circuit and SoM's RTC.
Expected Parameters: V_{in} = 6.0 - 8.4 V V_{out} = 3.26 V ± 2.42% I_{out} = 0.5 A η = 95.6 % Duty = 40 % f_{SW} = 614 kHz
Expected Parameters: V_{in} = 6.0 - 8.4 V V_{out} = 5 V ± 3.6 % I_{out} = 4 A η = 94.8 % Duty = 61 % f_{SW} = 519 kHz
