W5TSU/LinHT-hw/rf.kicad_sch

## KiCad design rf.kicad_sch (2026-09-17)

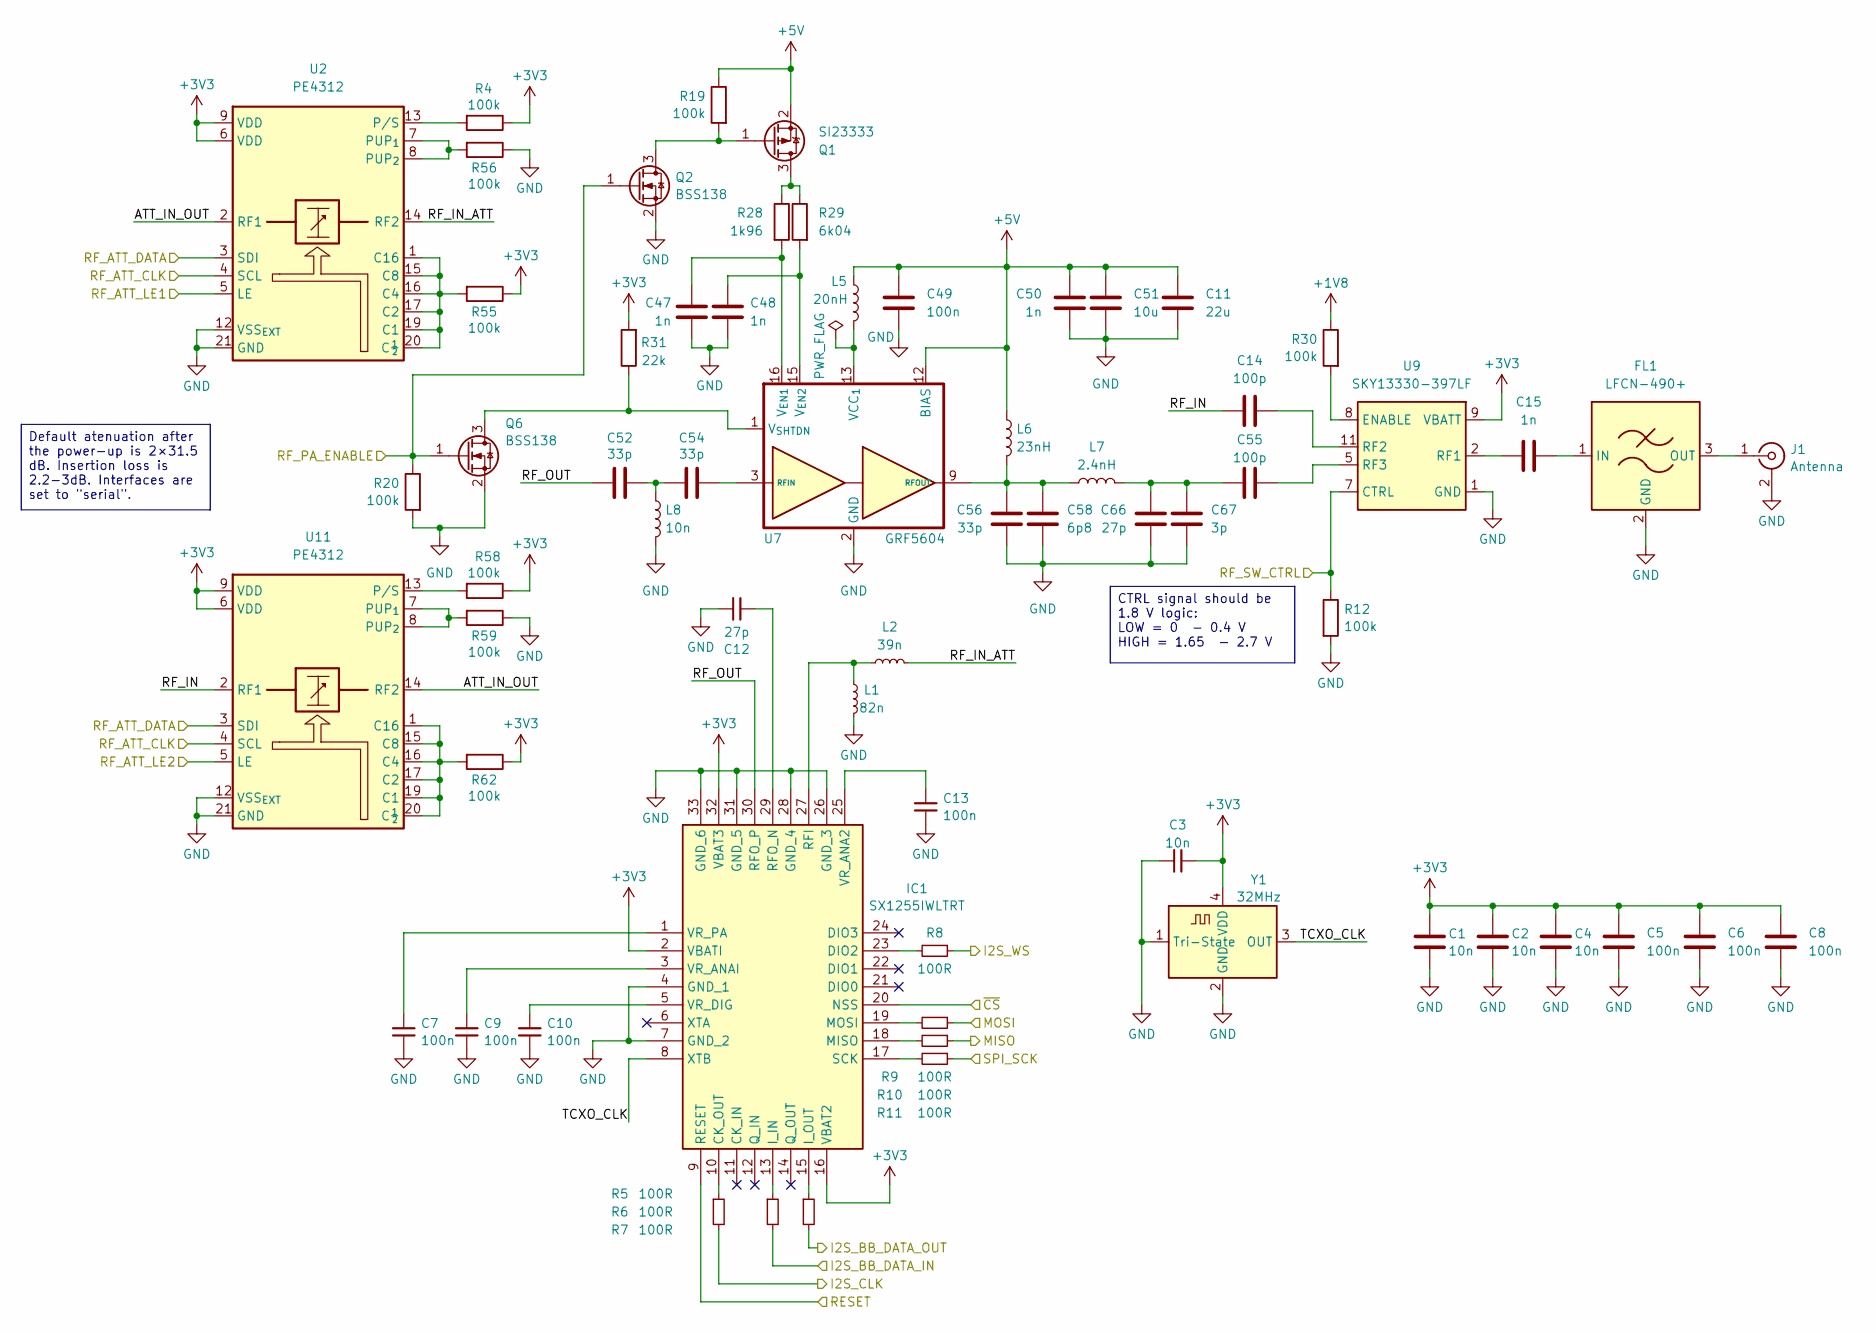
[picture p9: schematic rf.kicad_sch]

Parts:
C1, C2, C3, C4: 10n; C_0402_1005Metric; MPN CL05B103KO5NNNC; LCSC C318577
C5, C6, C7, C8, C9, C10, C13, C49: 100n; C_0402_1005Metric; MPN CL05B104KO5NNNC; LCSC C1525
C11: 22u; C_1206_3216Metric; MPN CL31B226KPHNNNE; LCSC C87996
C12, C66: 27p; C_0402_1005Metric; MPN CC0402JRNPO9BN270; LCSC C107002
C14, C55: 100p; C_0402_1005Metric; MPN GRM1555C1H101JA01D; LCSC C77177
C15, C47, C48, C50: 1n; C_0402_1005Metric; MPN CC0402JRNPO9BN102; LCSC C113780
C51: 10u; C_0402_1005Metric; MPN CL05A106MQ5NUNC; LCSC C15525
C52, C54, C56: 33p; C_0402_1005Metric; MPN GJM1555C1H330FB01D; LCSC C464434
C58: 6p8; C_0402_1005Metric; MPN GJM1555C1H6R8BB01D; LCSC C88896
C67: 3p; C_0402_1005Metric; MPN GJM1555C1H3R0BB01D; LCSC C88891
FL1: LFCN-490+; Filter_Mini-Circuits_FV1206; MPN LFCN-490+; LCSC C3008205
IC1: SX1255IWLTRT; QFN50P500X500X80-33N-D; Manufacturer_Part_Number SX1255IWLTRT; LCSC C89372
J1: Antenna; Connector_SMA_4x10mm
L1: 82n; L_0603_1608Metric; MPN AISC-0603-R082J-T; LCSC C186899
L2: 39n; L_0603_1608Metric; MPN AISC-0603-R039J-T; LCSC C186893
L5: 20nH; L_0402_1005Metric; MPN 0402HP-20NXGRW; LCSC C40976557
L6: 23nH; 0908SQ-23N; MPN XR0908SQ-23NJLC; LCSC C42418190
L7: 2.4nH; L_0603_1608Metric; MPN LQW18AN2N4C8ZD; LCSC C2042508
L8: 10n; L_0402_1005Metric; MPN LQG15HH10NJ02D; LCSC C668375
Q1: SI23333; SOT-23; MPN SI2333; LCSC C344008
Q2, Q6: BSS138; SOT-23; MPN BSS138-7-F; LCSC C40912
R4, R12, R19, R20, R30, R55, R56, R58, R59, R62: 100k; R_0402_1005Metric; MPN 0402WGF1003TCE; LCSC C25741
R5, R6, R7, R8, R9, R10, R11: 100R; R_0402_1005Metric; MPN 0402WGF1000TCE; LCSC C25076
R28: 1k96; R_0402_1005Metric; MPN 0402WGF1961TCE; LCSC C70427
R29: 6k04; R_0402_1005Metric; MPN 0402WGF6041TCE; LCSC C25913
R31: 22k; R_0402_1005Metric; MPN 0402WGF2202TCE; LCSC C25768
U2, U11: PE4312; QFN-20-1EP_4x4mm_P0.5mm_EP2.5x2.5mm; MPN PE4312C-Z; LCSC C500480
U7: GRF5604; QFN-16-1EP_3x3mm_P0.5mm_EP1.7x1.7mm_ThermalVias; MPN GRF5604
U9: SKY13330-397LF; QFN-12_L2.0-W2.0-P0.50-BL-EP0.8; MPN SKY13330-397LF; LCSC C2654715
Y1: 32MHz; Crystal_SMD_2016-4Pin_2.0x1.6mm; MPN ECS-TXO-20CSMV4-320-AY-TR; LCSC C19858587

Connections:
+1V8: R30.1
+3V3: C1.1, C2.1, C3.1, C4.1, C5.1, C6.1, C8.1, IC1.2 (VBATI), IC1.16 (VBAT2), IC1.32 (VBAT3), R4.1, R31.2, R55.1, R58.1, R62.1, U2.6 (VDD), U2.9 (VDD), U9.9 (VBATT), U11.6 (VDD), U11.9 (VDD), Y1.4 (VDD)
+5V: C11.1, C49.2, C50.2, C51.2, L5.1, L6.1, Q1.2 (S), R19.1, U7.12 (BIAS)
ATT_IN_OUT: U2.2 (RF1), U11.14 (RF2)
GND: C1.2, C2.2, C3.2, C4.2, C5.2, C6.2, C7.2, C8.2, C9.2, C10.2, C11.2, C12.2, C13.2, C47.2, C48.2, C49.1, C50.1, C51.1, C56.1, C58.1, C66.1, C67.1, FL1.2 (GND), FL1.4 (GND), IC1.4 (GND_1), IC1.7 (GND_2), IC1.26 (GND_3), IC1.28 (GND_4), IC1.31 (GND_5), IC1.33 (GND_6), J1.2 (Ext), L1.1, L8.2, Q2.2 (S), Q6.2 (S), R12.2, R20.2, R56.1, R59.1, U2.10 (GND), U2.11 (GND), U2.12 (VSS_{EXT}), U2.18 (GND), U2.21 (GND), U7.2 (GND), U7.5 (GND), U7.6 (GND), U7.7 (GND), U7.8 (GND), U7.11 (GND), U7.14 (GND), U7.17 (GND), U9.1 (GND), U9.3 (GND), U9.4 (GND), U9.6 (GND), U9.10 (GND), U9.12 (GND), U9.13 (GND), U11.10 (GND), U11.11 (GND), U11.12 (VSS_{EXT}), U11.18 (GND), U11.21 (GND), Y1.1 (Tri-State), Y1.2 (GND)
I2S_BB_DATA_IN: R6.2
I2S_BB_DATA_OUT: R7.2
I2S_CLK: R5.2
I2S_WS: R8.1
MISO: R10.1
MOSI: R9.1
unnamed: C7.1, IC1.1 (VR_PA)
unnamed: C9.1, IC1.3 (VR_ANAI)
unnamed: C10.1, IC1.5 (VR_DIG)
unnamed: C12.1, IC1.29 (RFO_N)
unnamed: C13.1, IC1.25 (VR_ANA2)
unnamed: C14.2, U9.11 (RF2)
unnamed: C15.1, U9.2 (RF1)
unnamed: C15.2, FL1.1 (IN)
unnamed: C47.1, R28.2, U7.16 (V_{EN1})
unnamed: C48.1, R29.2, U7.15 (V_{EN2})
unnamed: C52.2, C54.1, L8.1
unnamed: C54.2, U7.3 (RFIN), U7.4 (RFIN)
unnamed: C55.1, C66.2, C67.2, L7.2
unnamed: C55.2, U9.5 (RF3)
unnamed: C56.2, C58.2, L6.2, L7.1, U7.9 (RFOUT), U7.10 (RFOUT)
unnamed: FL1.3 (OUT), J1.1 (In)
unnamed: IC1.10 (CK_OUT), R5.1
unnamed: IC1.13 (I_IN), R6.1
unnamed: IC1.15 (I_OUT), R7.1
unnamed: IC1.17 (SCK), R11.2
unnamed: IC1.18 (MISO), R10.2
unnamed: IC1.19 (MOSI), R9.2
unnamed: IC1.23 (DIO2), R8.2
unnamed: IC1.27 (RFI), L1.2, L2.2
unnamed: L5.2, U7.13 (VCC_{1})
unnamed: Q1.1 (G), Q2.3 (D), R19.2
unnamed: Q1.3 (D), R28.1, R29.1
unnamed: Q6.3 (D), R31.1, U7.1 (V_{SHTDN})
unnamed: R4.2, U2.13 (P/S)
unnamed: R30.2, U9.8 (ENABLE)
unnamed: R55.2, U2.1 (C16), U2.15 (C8), U2.16 (C4), U2.17 (C2), U2.19 (C1), U2.20 (C½)
unnamed: R56.2, U2.7 (PUP_{1}), U2.8 (PUP_{2})
unnamed: R58.2, U11.13 (P/S)
unnamed: R59.2, U11.7 (PUP_{1}), U11.8 (PUP_{2})
unnamed: R62.2, U11.1 (C16), U11.15 (C8), U11.16 (C4), U11.17 (C2), U11.19 (C1), U11.20 (C½)
RESET: IC1.9 (RESET)
RF_ATT_CLK: U2.4 (SCL), U11.4 (SCL)
RF_ATT_DATA: U2.3 (SDI), U11.3 (SDI)
RF_ATT_LE1: U2.5 (LE)
RF_ATT_LE2: U11.5 (LE)
RF_IN: C14.1, U11.2 (RF1)
RF_IN_ATT: L2.1, U2.14 (RF2)
RF_OUT: C52.1, IC1.30 (RFO_P)
RF_PA_ENABLE: Q2.1 (G), Q6.1 (G), R20.1
RF_SW_CTRL: R12.1, U9.7 (CTRL)
SPI_SCK: R11.1
TCXO_CLK: IC1.8 (XTB), Y1.3 (OUT)
~CS: IC1.20 (NSS)

Notes on the sheet:
CTRL signal should be 1.8 V logic: LOW = 0 - 0.4 V HIGH = 1.65 - 2.7 V
Default atenuation after the power-up is 2×31.5 dB. Insertion loss is 2.2-3dB. Interfaces are set to "serial".
