W5TSU/LinHT-hw/soc.kicad_sch

## KiCad design soc.kicad_sch (2026-09-17)

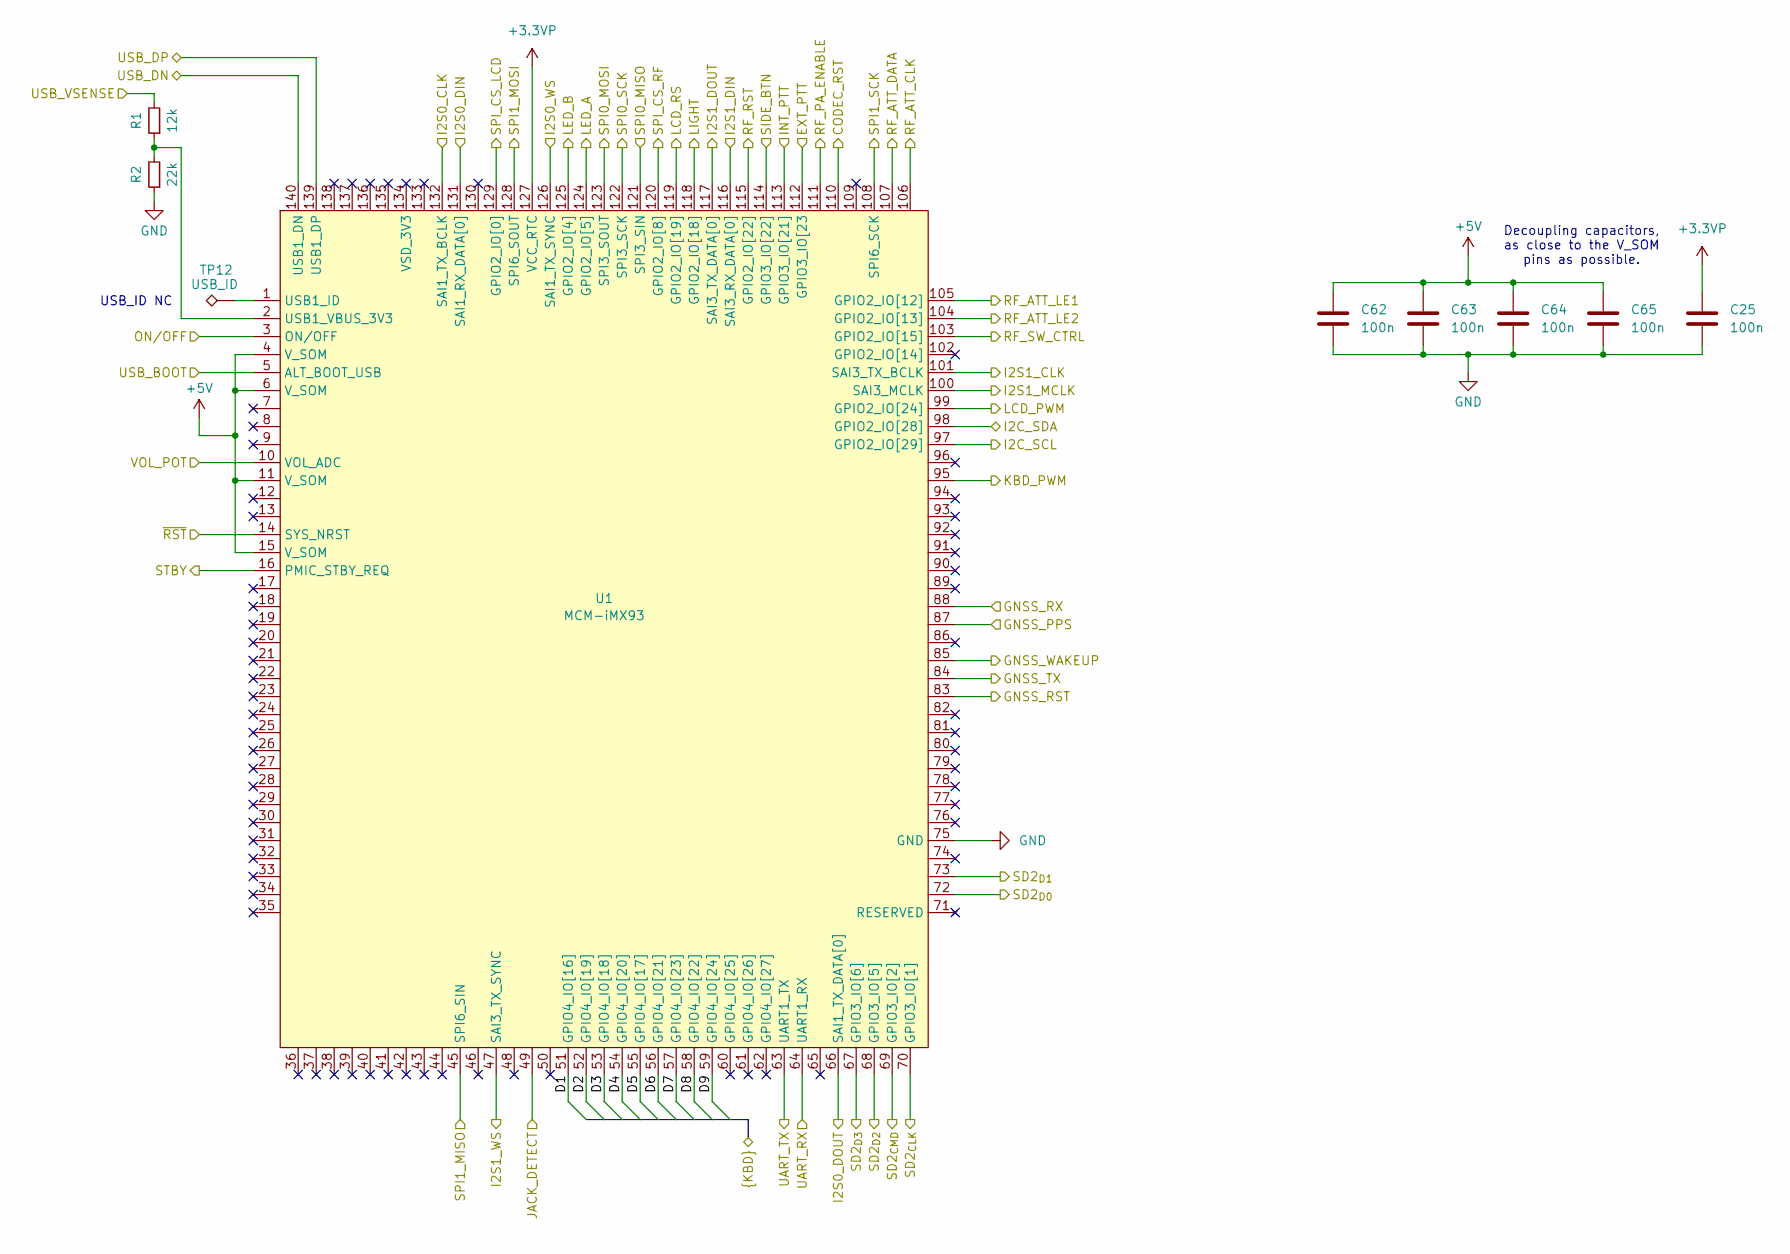
[picture p10: schematic soc.kicad_sch]

Parts:
C25, C62, C63, C64, C65: 100n; C_0402_1005Metric; MPN CL05B104KO5NNNC; LCSC C1525
R1: 12k; R_0402_1005Metric; MPN 0402WGF1202TCE; LCSC C25752
R2: 22k; R_0402_1005Metric; MPN 0402WGF2202TCE; LCSC C25768
TP12: USB_ID; TestPoint_Pad_D1.0mm
U1: MCM-iMX93; MPN MCM-iMX93-C1700D-D2-N32

Connections:
+3.3VP: C25.1, U1.127 (VCC_RTC)
+5V: C62.1, C63.1, C64.1, C65.1, U1.4 (V_SOM), U1.6 (V_SOM), U1.11 (V_SOM), U1.15 (V_SOM)
CODEC_RST: U1.110
D1: U1.51 (GPIO4_IO[16])
D2: U1.52 (GPIO4_IO[19])
D3: U1.53 (GPIO4_IO[18])
D4: U1.54 (GPIO4_IO[20])
D5: U1.55 (GPIO4_IO[17])
D6: U1.56 (GPIO4_IO[21])
D7: U1.57 (GPIO4_IO[23])
D8: U1.58 (GPIO4_IO[22])
D9: U1.59 (GPIO4_IO[24])
EXT_PTT: U1.112 (GPIO3_IO[23)
GND: C25.2, C62.2, C63.2, C64.2, C65.2, R2.1, U1.75 (GND), U1.G1 (GND), U1.G2 (GND), U1.G3 (GND), U1.G4 (GND), U1.G5 (GND), U1.G6 (GND), U1.G7 (GND), U1.G8 (GND), U1.G9 (GND), U1.G10 (GND), U1.G11 (GND), U1.G12 (GND), U1.G13 (GND), U1.G14 (GND), U1.G15 (GND), U1.G16 (GND), U1.G17 (GND), U1.G18 (GND), U1.G19 (GND), U1.G20 (GND), U1.G21 (GND), U1.G22 (GND), U1.G23 (GND), U1.G24 (GND)
GNSS_PPS: U1.87
GNSS_RST: U1.83
GNSS_RX: U1.88
GNSS_TX: U1.84
GNSS_WAKEUP: U1.85
I2C_SCL: U1.97 (GPIO2_IO[29])
I2C_SDA: U1.98 (GPIO2_IO[28])
I2S0_CLK: U1.132 (SAI1_TX_BCLK)
I2S0_DIN: U1.131 (SAI1_RX_DATA[0])
I2S0_DOUT: U1.66 (SAI1_TX_DATA[0])
I2S0_WS: U1.126 (SAI1_TX_SYNC)
I2S1_CLK: U1.101 (SAI3_TX_BCLK)
I2S1_DIN: U1.116 (SAI3_RX_DATA[0])
I2S1_DOUT: U1.117 (SAI3_TX_DATA[0])
I2S1_MCLK: U1.100 (SAI3_MCLK)
I2S1_WS: U1.47 (SAI3_TX_SYNC)
INT_PTT: U1.113 (GPIO3_IO[21])
JACK_DETECT: U1.49
KBD_PWM: U1.95
LCD_PWM: U1.99 (GPIO2_IO[24])
LCD_RS: U1.119 (GPIO2_IO[19])
LED_A: U1.124 (GPIO2_IO[5])
LED_B: U1.125 (GPIO2_IO[4])
LIGHT: U1.118 (GPIO2_IO[18])
unnamed: R1.1, R2.2, U1.2 (USB1_VBUS_3V3)
unnamed: TP12.1, U1.1 (USB1_ID)
ON/OFF: U1.3 (ON/OFF)
RF_ATT_CLK: U1.106
RF_ATT_DATA: U1.107
RF_ATT_LE1: U1.105 (GPIO2_IO[12])
RF_ATT_LE2: U1.104 (GPIO2_IO[13])
RF_PA_ENABLE: U1.111
RF_RST: U1.115 (GPIO2_IO[22])
RF_SW_CTRL: U1.103 (GPIO2_IO[15])
SD2_{CLK}: U1.70 (GPIO3_IO[1])
SD2_{CMD}: U1.69 (GPIO3_IO[2])
SD2_{D0}: U1.72
SD2_{D1}: U1.73
SD2_{D2}: U1.68 (GPIO3_IO[5])
SD2_{D3}: U1.67 (GPIO3_IO[6])
SIDE_BTN: U1.114 (GPIO3_IO[22])
SPI0_MISO: U1.121 (SPI3_SIN)
SPI0_MOSI: U1.123 (SPI3_SOUT)
SPI0_SCK: U1.122 (SPI3_SCK)
SPI1_MISO: U1.45 (SPI6_SIN)
SPI1_MOSI: U1.128 (SPI6_SOUT)
SPI1_SCK: U1.108 (SPI6_SCK)
SPI_CS_LCD: U1.129 (GPIO2_IO[0])
SPI_CS_RF: U1.120 (GPIO2_IO[8])
STBY: U1.16 (PMIC_STBY_REQ)
UART_RX: U1.64 (UART1_RX)
UART_TX: U1.63 (UART1_TX)
USB_BOOT: U1.5 (ALT_BOOT_USB)
USB_DN: U1.140 (USB1_DN)
USB_DP: U1.139 (USB1_DP)
USB_VSENSE: R1.2
VOL_POT: U1.10 (VOL_ADC)
~RST: U1.14 (SYS_NRST)

Notes on the sheet:
Decoupling capacitors, as close to the V_SOM pins as possible.
USB_ID NC
