W5TSU/LinHT-hw/(commit log)

2026-09-17 Complete Mouser part numbers for Rev C
    [audio.kicad_sch, connectors.kicad_sch, display.kicad_sch, gnss.kicad_sch, keyboard.kicad_sch, linht-hw.kicad_sch, mux.kicad_sch, power.kicad_sch]
2026-09-24 README: design files are KiCad 10 format
2026-09-24 Add US PCB fab and assembly survey for Rev C
2026-09-24 Add Rev C parts sourcing plan and Mouser-priced BOM
    [sourcing-bom.csv]
2026-09-24 Sync PCB footprint fields from schematic
    Update PN, MPN, LCSC, Mouser, Description and D4/D5 values on the
    PCB footprints to match the schematic. Field text only; no footprint,
    pad, track, zone or net changes. KiCad 10 schematic parity drops from
    202 issues to 1 (J12 shield pads still numbered S1, symbol pin is SH).
