W5TSU/LinHT-hw/(notices)

Notices in the files:
README.md:
CC BY-NC-SA 4.0
